Caetani/Instrumentation_Project/Molar Fraction Measurement Circuit/Molar fraction measurement circuit.txt

time	V(out)
Step Information: Cx=10f  (Run: 1/11)
0.000000000000000e+000	2.979928e+000
1.059367792182870e-009	2.979928e+000
3.178103376549456e-009	2.979925e+000
7.415574545281783e-009	2.979918e+000
1.589051688274644e-008	2.979897e+000
3.284040155767659e-008	2.979841e+000
4.964008978899125e-008	2.979773e+000
6.479165434650615e-008	2.979707e+000
8.026158825470863e-008	2.979642e+000
9.768412347564970e-008	2.979575e+000
1.385574938984662e-007	2.979456e+000
1.761488545973508e-007	2.979388e+000
2.309738601106873e-007	2.979342e+000
2.758752168679751e-007	2.979334e+000
3.256717974471726e-007	2.979339e+000
4.977462139484399e-007	2.979360e+000
1.358225596605115e-006	2.979358e+000
2.256010269847791e-006	2.979356e+000
3.453056500838026e-006	2.979354e+000
5.847148962818495e-006	2.979351e+000
9.847148962818494e-006	2.979348e+000
1.384714896281850e-005	2.979346e+000
1.734416608922869e-005	2.979346e+000
2.110221188290852e-005	2.979347e+000
2.261908594551890e-005	2.979347e+000
2.450194294303486e-005	2.979348e+000
2.631483034675033e-005	2.979349e+000
2.864002322106020e-005	2.979351e+000
3.240723046369560e-005	2.979354e+000
3.640723046369560e-005	2.979358e+000
4.040723046369560e-005	2.979362e+000
4.440723046369560e-005	2.979367e+000
4.840723046369560e-005	2.979371e+000
5.240723046369560e-005	2.979374e+000
5.362981152497211e-005	2.979388e+000
5.387832213026632e-005	2.979424e+000
5.396519546780097e-005	2.979461e+000
5.404663925152859e-005	2.979503e+000
5.407255291597320e-005	2.979509e+000
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
9.017008659547225e-005	4.201641e-001
9.417008659547225e-005	4.201639e-001
9.817008659547224e-005	4.201637e-001
1.021700865954722e-004	4.201635e-001
1.061700865954722e-004	4.201632e-001
1.101700865954723e-004	4.201631e-001
1.141700865954723e-004	4.201630e-001
1.181700865954722e-004	4.201630e-001
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
