Caetani/Instrumentation_Project/Molar Fraction Measurement Circuit/Molar fraction measurement circuit.asc

C1: cap; {Cx}
C2: cap; 0.22p
C3: cap; 0.22p
C4: cap; 0.22p
Cp: cap; {Cp}
D1: schottky; BAT54
D2: schottky; BAT54
R1: res; {Rgnd}
R2: res; {Rgnd}
R3: res; 4.5K
R4: res; {Rup}
R5: res; {Rdown}
Rp: res; {Rp}
U1: AD8421
U2: OP1177
U3: OP1177
U4: OP1177
V1: voltage; SINE(0 3.3 10k); AC 1
V4: voltage; 15
V5: voltage; 15
Named nets: 0, Vs, e1, e2, Vdif, ref, +15V, -15V, Vout
.step param Cx 0.01p 0.2p 0.01p
.tran 0 15.1m 15m startup
.param Rgnd 50Meg
*.step temp list -10 50
.param tensao_ref 0.3
.param Rdown tensao_ref*1000
.param Rup 15000-Rdown
.param Rp 1k
.param Cp 240n
*.param Cx 0.105p
