Caetani/Instrumentation_Project/Pressure Measurement Circuit/Pressure measurement circuit.asc

C1: cap; 440f
C2: cap; 440f
C3: cap; 440f
Cp: cap; {Cp}
Cx: cap; {Cx}
D1: schottky; BAT54
D2: schottky; BAT54
R1: res; {Rgnd}
R2: res; {Rgnd}
R3: res; 40
R4: res; {Rup}
R5: res; {Rdown}
Rp: res; {Rp}
U1: AD8421
U2: OP1177
U3: OP1177
U4: OP1177
V1: voltage; SINE(0 3.3 10k)
V4: voltage; 15
V5: voltage; 15
Named nets: 0, Vs, e1, e2, Vdif, ref, +15V, -15V, Vout
.step param Cx 428f 435f 1f
.tran 0 16m 15m startup
.param Rgnd 22Meg
*.step temp list -10 50
*.ac dec 10 1 10meg
.param tensao_ref 9
.param Rdown tensao_ref*1000
.param Rup 15000-Rdown
.param Rp 1k
.param Cp 1u
*.param Cx 0.105p
