Caetani/Instrumentation_Project/Temperature Measurement Circuit/Temperature measurement circuit.asc

5V: voltage; 5
I1: current; {Is}
R2: res; {Rf4}
R3: res; 2k
R4: res; {Rf2}
R5: res; {Rf3}
R6: res; 3k
R_Pt100: res; {Rpt}
Rf1: res; {Rf1}
RG1: res; 1800
RG2: res; 4.2k
U1: AD8421
U2: AD8421
V1: voltage; 5
V2: voltage; 5
V3: voltage; 18
V4: voltage; 18
Named nets: V+, 0, +5V, -5V, V-, +18V, -18V, ref, V_AI1, Vout
.step temp -10 50 10
;tran 0 1 0
.param Ro 100
.param A 3.9083*10**-3
.param B -5.775*10**-7
.param Rpt=Ro*(1+A*temp+B*temp**2)
.param Rf1 Rfio
.param Rf2 Rfio
.param Rf3 Rfio
.param Rf4 Rfio
.param Is 5m
.param Rfio 10
*Rg1 = 1900 ---> Ganho aprox. 4
;op 0 1 0
.ac dec 10 1 1meg
