Caetani/Instrumentation_Project/(commit log)

2023-07-22 Adding files.
    [molecular_weight_data.xlsx, vout vs temp.xlsx]
2023-07-22 Adding circuit models in LTSpice
2023-07-23 Wrong excel file was being used.
    [gas_density_dataset.xlsx]
2023-07-23 Delete molecular_weight_data.xlsx
    Wrong file
    [molecular_weight_data.xlsx]
